rmarabini/ElectronMicroscopeMonitor/Magnetometer/images/flc100.jpg

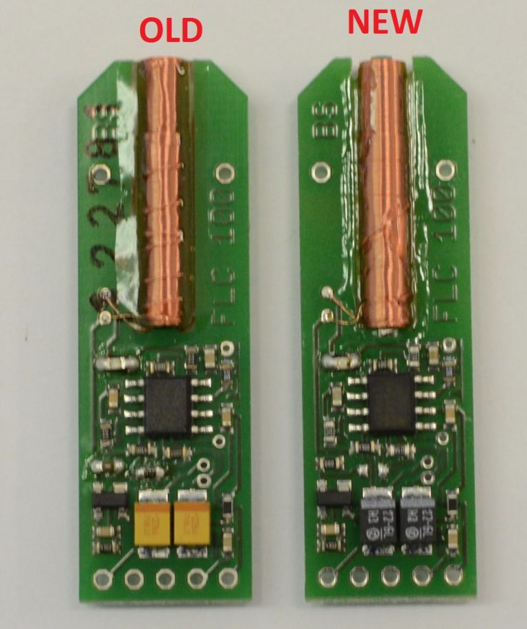
Magnetometer/images/flc100.jpg
