rmarabini/ElectronMicroscopeMonitor/README.md

# ElectronMicroscopeMonitor
This project will measure temperature, magnetic field and vibration

See Wiki for details
