rmarabini/ElectronMicroscopeMonitor/Magnetometer/Rpi_Magnetometer_build/Perspex_stand_design.pdf

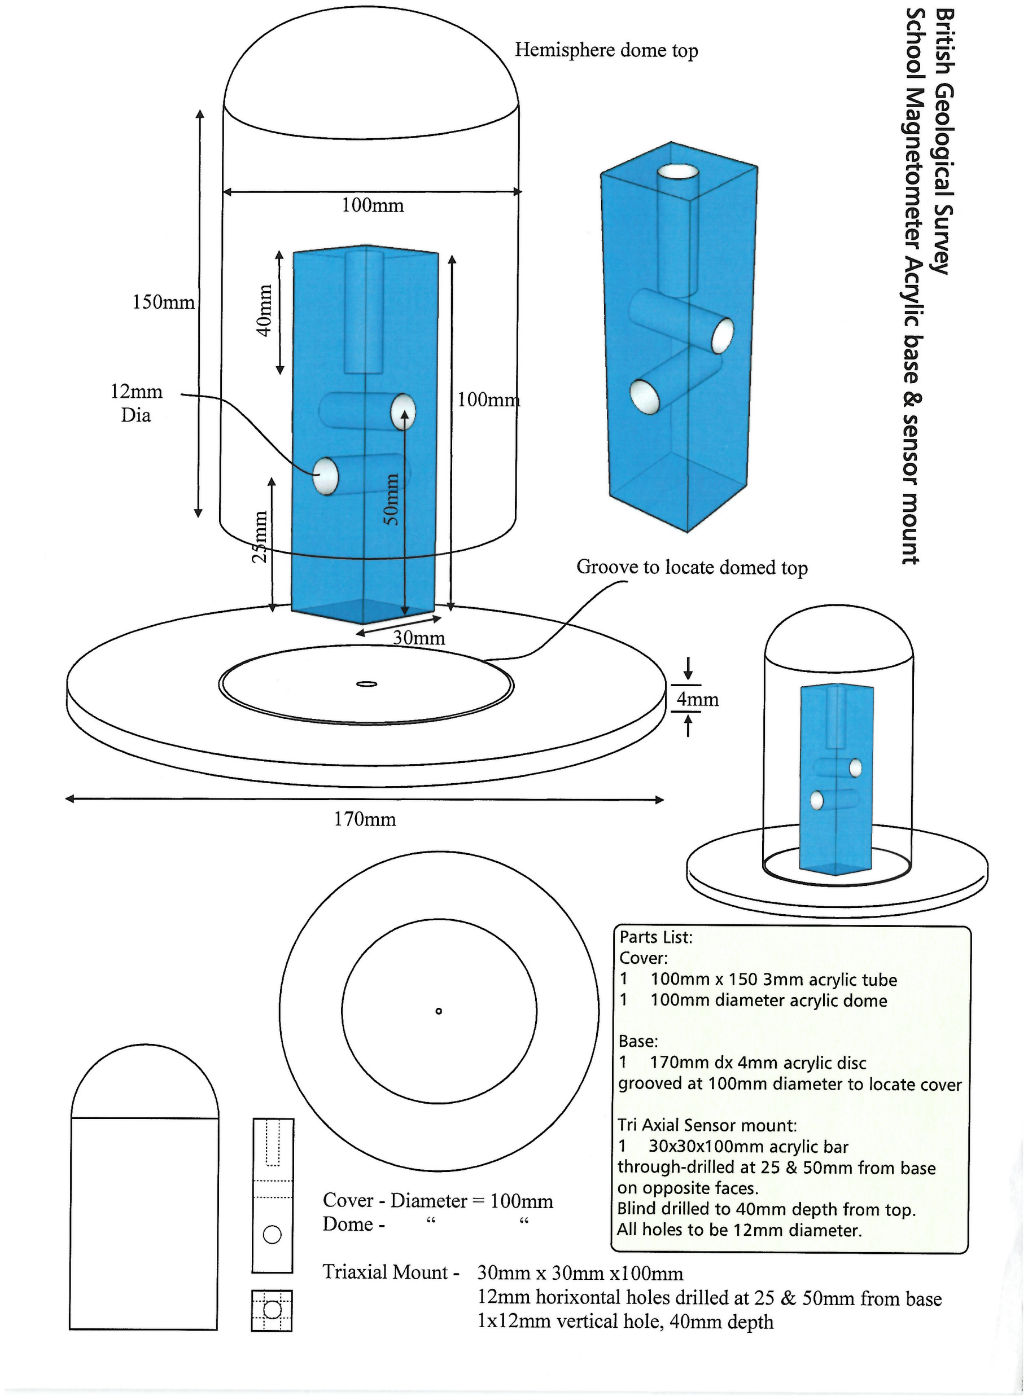
[picture p2: page 1]
