rmarabini/ElectronMicroscopeMonitor/Magnetometer/Rpi_Magnetometer_build/Example_PartsList_Costings.xlsx

Raspberry Pi parts list
Materials | Price | Suggested web address
 | per unit (£)
Raspberry Pi B+ or v2 + 8Gb SD card | 34 | https://www.modmypi.com/
AB Electronics | 22 | https://www.abelectronics.co.uk/products/17/Raspberry-Pi--Raspberry-Pi-2-Model-B/56/ADC-Pi-Plus---Raspberry-Pi-Analogue-to-Digital-converter
FL100 x3 | €150 | http://www.stefan-mayer.com/en/products/magnetometers-and-sensors/magnetic-field-sensor-flc-100.html
wires/clips | 15 | http://www.maplin.co.uk
Rpi case | 6 | https://www.modmypi.com/
Rpi power supply | 6 | https://www.modmypi.com/
Wifi dongle | 8 | https://www.modmypi.com/
Plastic/perspex case | 15 | Try Ebay or 'borrowing' from the workshop?
Keyboard/mouse | 20
Also needed are HDMI cable and HDMI monitor
10 x 10 mm perspex bar on Ebay |  | http://www.ebay.co.uk/itm/10mm-x-10mm-Clear-Acrylic-SQUARE-Profile-500mm-Plastic-Plexiglas-Perspex-Bar-/300938223985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
100 mm tubing for protective case |  | http://stores.ebay.co.uk/Clear-Plastic-Supplies?_trksid=p2047675.l2563
