rmarabini/ElectronMicroscopeMonitor/Magnetometer/Rpi_Magnetometer_build/Magnetometer Wiring.docx

# School Magnetometers

## Cable / Connector Diagrams

#### Tim Taylor (photos Ciaran Beggan)

Wiring Diagram:

5V

FG1 FG2 FG3

GND +5V SYN O- O+ GND +5V SYN O- O+ GND +5V SYN O- O+

FG1 O- Ther Vf LED

O+

FG2 O- Vo

O+

FG3 O- V0

O+

Therm O

0V

9 cores required in cable

Cable Colours:

10 core cable (shielded) to be used.

Colour Rd Or Ye Gr Bu Pu Bl Br Gy Wh

Use +5 FG1+ FG2+ FG3+ FG1- FG2- 0V FG3- The xx

Pin # 1 3 4 5 7 8 2 9 6

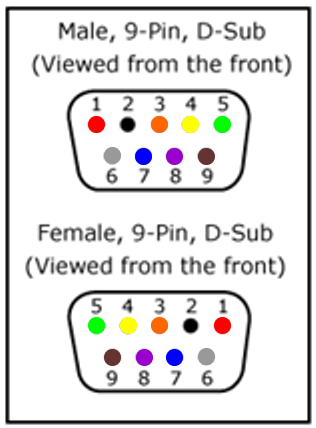
[picture p3: figure]
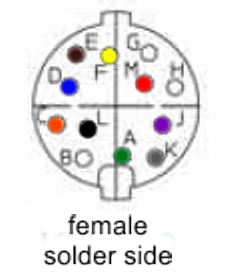
[picture p4: figure]
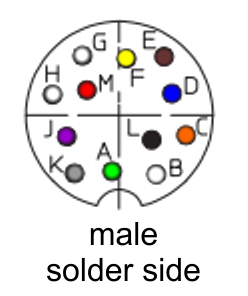
[picture p5: figure]
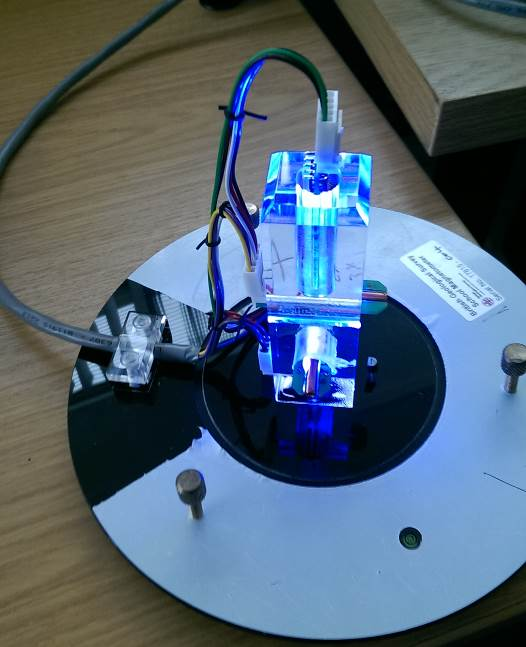
[picture p6: figure]

LED (wire under base)

TMP36 (wire under base)

FGM1

FGM2

FGM3

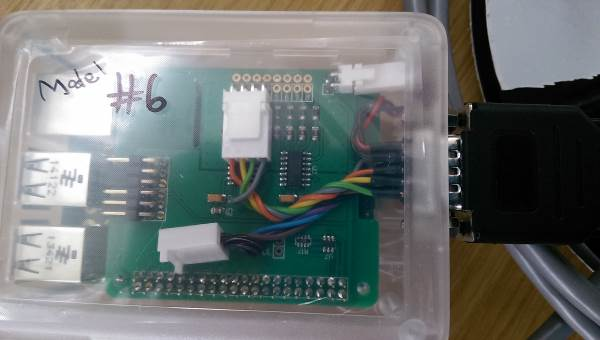
[picture p7: figure]

Connection to digitiser

Wire Tie

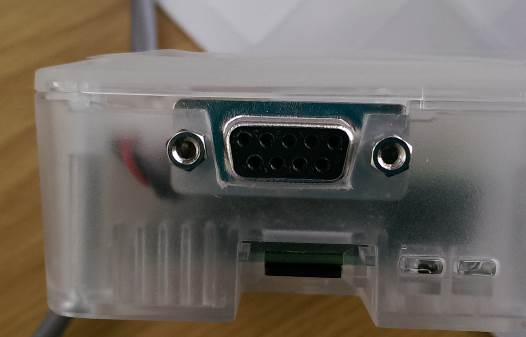
[picture p8: figure]

9-pin connector

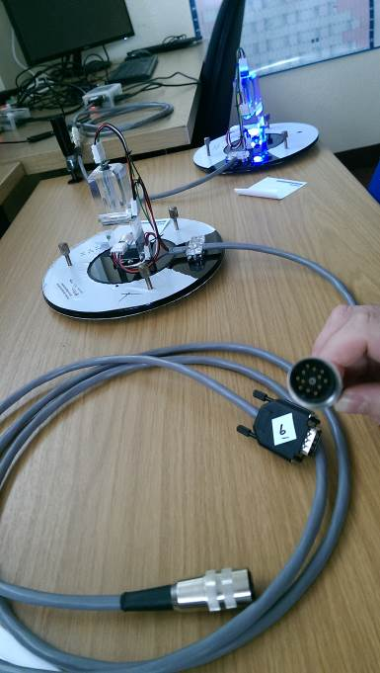
[picture p9: figure]

Extension cable to Raspberry Pi has round 12-pin connectors
