rmarabini/ElectronMicroscopeMonitor/Magnetometer/Rpi_Magnetometer_build/RaspberryPiMagnetometer_FLC100small.pdf

# Raspberry Pi Magnetometer

Sep 12 | Sep 13 | Sep 14 | Sep 15 | Sep 16 | Sep 17 | Sep 18

−150

−100

−50

0

50

100

150

Variation of Horizontal Strength

Magnetic field strength (nT)

Raspberry Pi (Edinburgh)
BGS Instrument (Eskdalemuir)

A Raspberry Pi is a cheap credit-card sized computer. We have added a three-axis magnetometer that is useful for detecting the magnetic effects of Space Weather events such as geomagnetic storms, aurora borealis, solar flares and pulsations.
Each magnetometer contains three fluxgate magnetometer sensors to detect very small magnetic field changes.

The sensors are mounted in a perspex block and wired up to an analog to digital converter. The analog to digital converter is connected to a Raspberry Pi computer to power the sensor and record the measurements. The data can be shared on the internet or displayed on screen.

The Rpi magnetometer can
almost match the accuracy of the scientific instruments at the BGS Eskdalemuir
magnetic observatory (left). Root-mean-square
differences of around 1nT
were measured between the
Rpi and the scientific sensors.

For further information: http://www.geomag.bgs.ac.uk/education/raspberry_pi_magnetometer.html

Geomagnetic Storm

Natural Daily Variation

Pulsations | Manmade disturbance
