rmarabini/ElectronMicroscopeMonitor/(list of files, drawings)

Other design files:
Fritz/tempSensor.fzz
Fritz/tempSensor_pcb.fzz
