rmarabini/ElectronMicroscopeMonitor/(commit log)

2019-12-02 add magnetic sensor
    [tempSensor.fzz]
2019-12-22 add sample script
2019-12-22 first magnetometer commit
2019-12-22 mv bayeosraspberrypi
    [tempSensor.fzz]
2020-01-11 pbc attached to Pi
    [tempSensor.fzz]
2020-01-11 added new tmp probe
2020-03-22 added vibration sensor and second temperature sensor
    [kk.fzz]
2020-04-11 mv kk.fzz tempSensor.fzz
    [kk.fzz, tempSensor.fzz]
2020-04-12 update record.py -> adxl55 - vibration
    [constants.py, demo-connection_loop.py, record.py]
2020-04-13 print x, y, z axis
2020-04-13 put u nit to y axis plot
2020-04-18 init fft in grafana
    [tempSensor.fzz]
2020-04-20 increase rate to 125 and print date to log
2020-04-20 read a few points and discard tem since many time first meassruments are wrong
    [vib_log_influxdb.py]
2020-04-20 move temperature sensor dictionary to constants
2020-04-20 add w1_slave to sensor filenanme
